VibrasticLab/pikoakustik/circuit/test_3rev1/end_stm32f401re.kicad_pcb

## KiCad design circuit/test_3rev1/end_stm32f401re.kicad_pcb (2020-10-08)

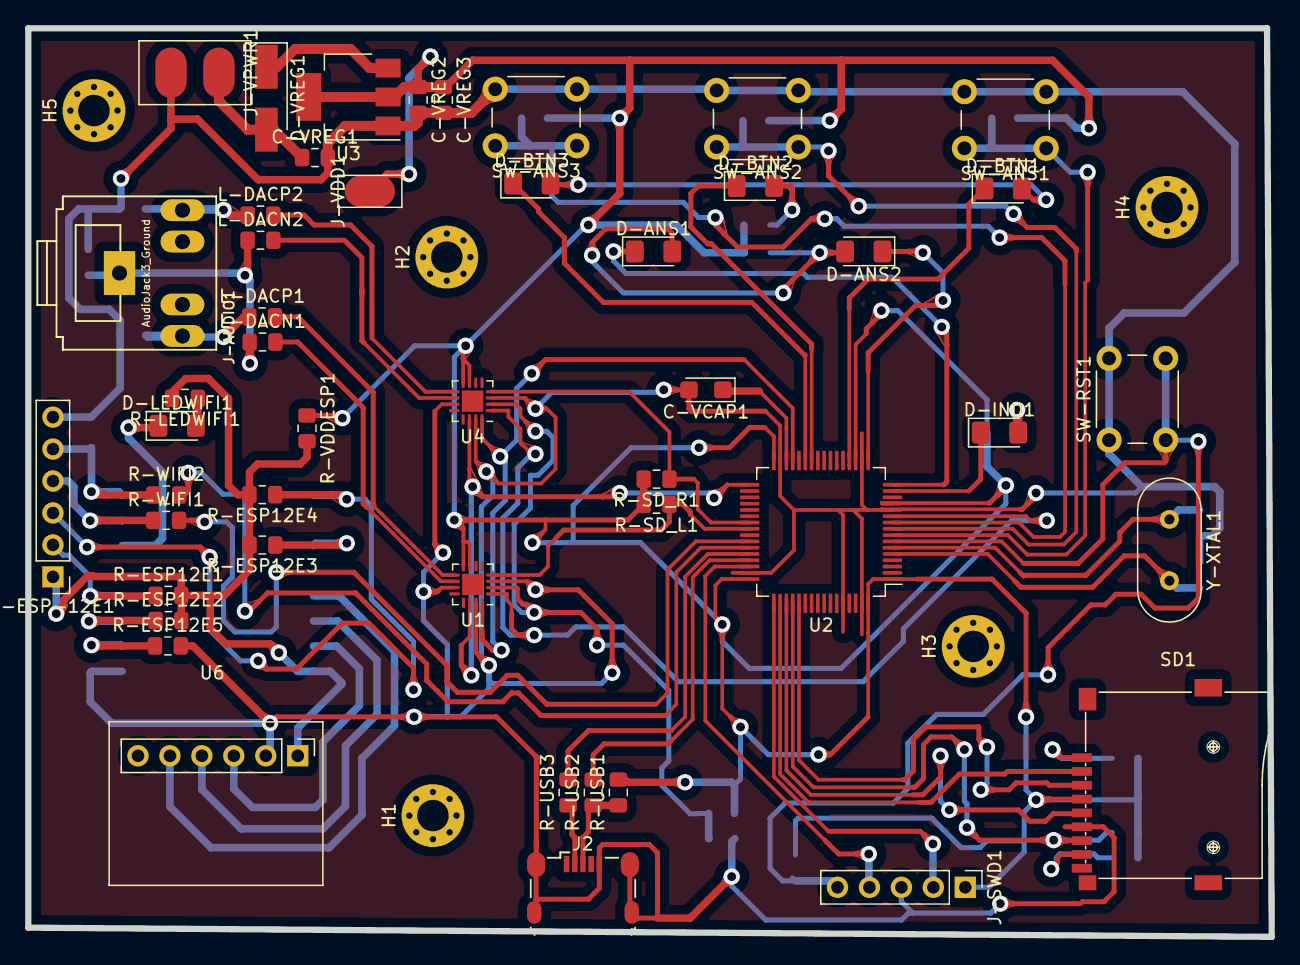
[picture p1: board end_stm32f401re.kicad_pcb from above]

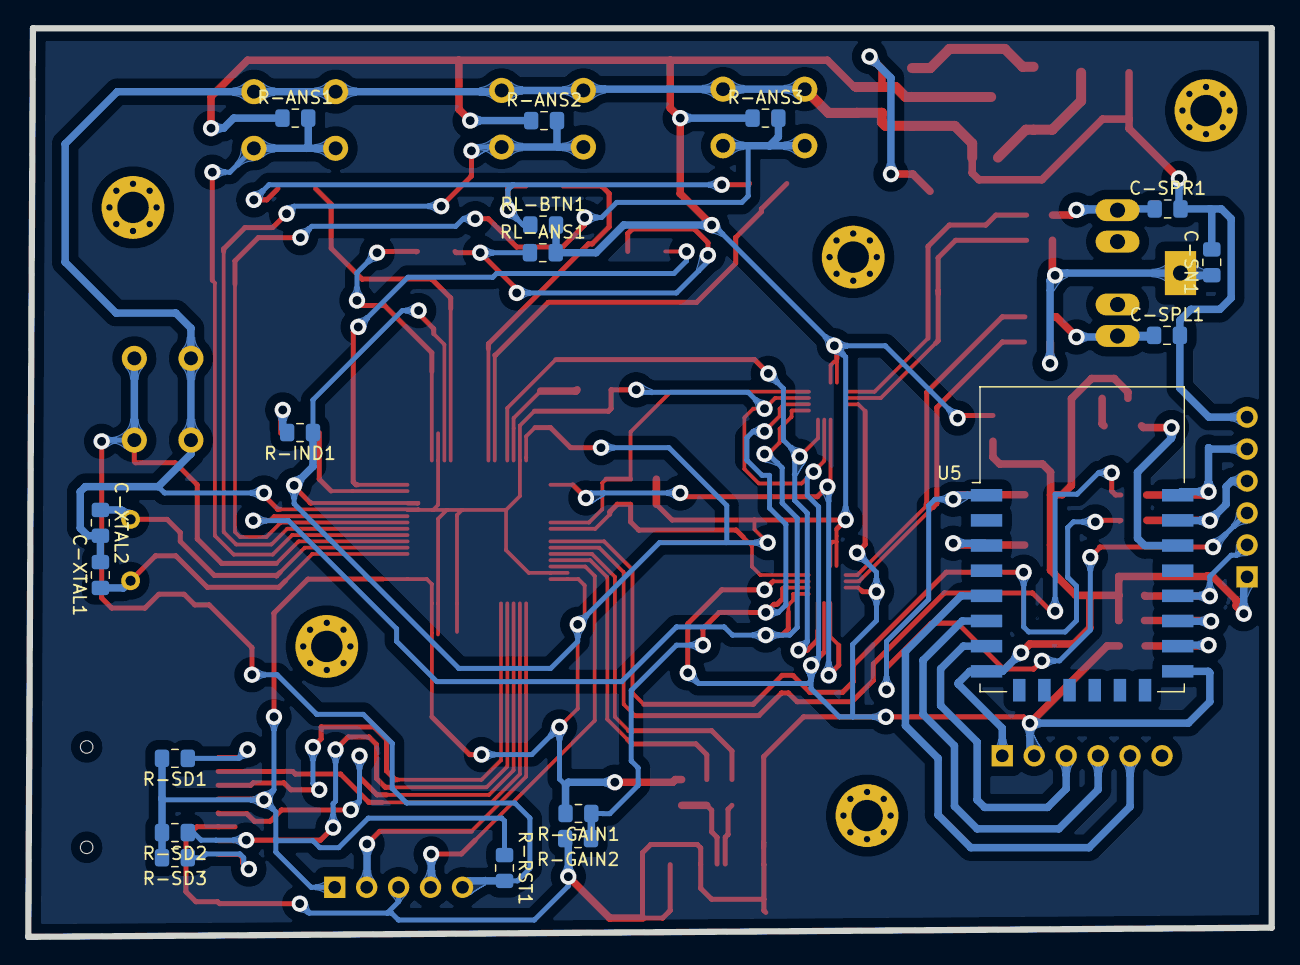
[picture p2: board end_stm32f401re.kicad_pcb from below]

Board: 2 copper layers, 98.9 x 72.2 mm, 70 parts (18 on the bottom side), 60 nets.

Parts:
C-SN1: 220pF; C_0805_2012Metric_Pad1.15x1.40mm_HandSolder
C-SPL1: 220pF; C_0805_2012Metric_Pad1.15x1.40mm_HandSolder
C-SPR1: 220pF; C_0805_2012Metric_Pad1.15x1.40mm_HandSolder
C-VCAP1: 4.7uF; CP_EIA-3216-18_Kemet-A
C-VREG1, C-VREG2, C-VREG3: C; C_0805_2012Metric_Pad1.15x1.40mm_HandSolder
C-XTAL1, C-XTAL2: C; C_0805_2012Metric_Pad1.15x1.40mm_HandSolder
D-ANS1, D-ANS2: LED; LED_1206_3216Metric_Pad1.42x1.75mm_HandSolder
D-BTN1, D-BTN2, D-BTN3: LED; LED_1206_3216Metric_Pad1.42x1.75mm_HandSolder
D-IND1: LED; LED_1206_3216Metric_Pad1.42x1.75mm_HandSolder
D-LEDWIFI1: LED; LED_1206_3216Metric_Pad1.42x1.75mm_HandSolder
D-VREG1: D; D_SMA_Handsoldering
H1, H2, H3, H4: MountingHole; MountingHole_2.5mm_Pad_Via
H5: CableHole; MountingHole_2.5mm_Pad_Via
J2: USB_B_Micro; MicroUSB
J-AUDIO1: AudioJack3_Ground; Tayda_3.5mm_stereo_TRS_jack_A-853
J-ESP-12E1: Conn_01x06_Male; PinHeader_1x06_P2.54mm_Vertical
J-SWD1: Conn_01x05_Male; PinHeader_1x05_P2.54mm_Vertical
J-VDD1: Conn_01x01_Male; vpin-x1
J-VPWR1: Conn_01x02_Male; vpin-x2
L-DACN1, L-DACN2: 100uH; L_0805_2012Metric_Pad1.15x1.40mm_HandSolder
L-DACP1, L-DACP2: 100uH; L_0805_2012Metric_Pad1.15x1.40mm_HandSolder
R-ANS1, R-ANS2, R-ANS3: 10K; R_0805_2012Metric_Pad1.15x1.40mm_HandSolder
R-ESP12E1, R-ESP12E2, R-ESP12E3, R-ESP12E4, R-ESP12E5: 10K; R_0805_2012Metric_Pad1.15x1.40mm_HandSolder
R-GAIN1, R-GAIN2: 100K; R_0805_2012Metric_Pad1.15x1.40mm_HandSolder
R-IND1: 330; R_0805_2012Metric_Pad1.15x1.40mm_HandSolder
R-LEDWIFI1: 330; R_0805_2012Metric_Pad1.15x1.40mm_HandSolder
R-RST1: 10K; R_0805_2012Metric_Pad1.15x1.40mm_HandSolder
R-SD1, R-SD2, R-SD3: 10K; R_0805_2012Metric_Pad1.15x1.40mm_HandSolder
R-SD_L1: 1M; R_0805_2012Metric_Pad1.15x1.40mm_HandSolder
R-SD_R1: 1M; R_0805_2012Metric_Pad1.15x1.40mm_HandSolder
R-USB1: 4K7; R_0805_2012Metric_Pad1.15x1.40mm_HandSolder
R-USB2, R-USB3: 68; R_0805_2012Metric_Pad1.15x1.40mm_HandSolder
R-VDDESP1: 0; R_0805_2012Metric_Pad1.15x1.40mm_HandSolder
R-WIFI1, R-WIFI2: 0; R_0805_2012Metric_Pad1.15x1.40mm_HandSolder
RL-ANS1: 330; R_0805_2012Metric_Pad1.15x1.40mm_HandSolder
RL-BTN1: 330; R_0805_2012Metric_Pad1.15x1.40mm_HandSolder
SD1: MICRO-SD-CARD-SOCKET-9P_ST-TF-003A_; MICRO-SD9+4P-SMD-16.1X14.5X1.85MM
SW-ANS1, SW-ANS2, SW-ANS3: SW_Push; SW_PUSH_6mm
SW-RST1: SW_Push; SW_PUSH_6mm
U1, U4: MAX98357; QFN-16-1EP_3x3mm_P0.5mm_EP1.7x1.7mm
U2: STM32F401RETx; LQFP-64_10x10mm_P0.5mm
U3: AMS1117-3.3; SOT-223-3_TabPin2
U5: ESP-12E
U6: SPH0645; sph0645
Y-XTAL1: 16MHz; Crystal_HC49-4H_Vertical

Connections:
/BTN_A: R-ANS1.2, SW-ANS1.1, U2.8
/BTN_B: R-ANS2.2, SW-ANS2.1, U2.9
/BTN_C: R-ANS3.2, SW-ANS3.1, U2.10
/DAC_BCLK: U1.16, U2.29, U4.16
/DAC_DIN: U1.1, U2.11, U4.1
/DAC_GAIN: R-GAIN1.1, R-GAIN2.1, U1.2, U4.2
/DAC_LRC: U1.14, U2.33, U4.14
/DAC_L_SD: R-SD_L1.1, U1.4, U2.40
/DAC_R_SD: R-SD_R1.1, U2.39, U4.4
/ESP_EN: R-ESP12E3.1, U5.3
/ESP_LEDWIFI: D-LEDWIFI1.1, U5.20
/ESP_P0: J-ESP-12E1.2, R-ESP12E1.1, U5.18
/ESP_P2: R-ESP12E2.1, U5.17
/ESP_P15: R-ESP12E5.1, U5.16
/ESP_RST: J-ESP-12E1.3, R-ESP12E4.1, U5.1
/ESP_RXD: J-ESP-12E1.4, R-WIFI1.1, U5.21
/ESP_TXD: J-ESP-12E1.5, R-WIFI2.1, U5.22
/LED_A: D-BTN1.1, U2.20
/LED_B: D-BTN2.1, U2.26
/LED_C: D-BTN3.1, U2.27
/LED_FALSE: D-ANS2.1, U2.17
/LED_IND: D-IND1.1, U2.15
/LED_TRUE: D-ANS1.1, U2.16
/MIC_BCLK: U5.7, U6.3
/MIC_DOUT: U5.6, U6.4
/MIC_LRCL: U5.5, U6.5
/MMC_MISO: R-SD2.1, SD1.7, U2.52
/MMC_MOSI: SD1.3, U2.53
/MMC_NSS: SD1.2, U2.50
/MMC_SCK: SD1.5, U2.51
/NRST: J-SWD1.5, R-RST1.2, SW-RST1.2, U2.7
/OUTN: C-SN1.1, J-AUDIO1.S, L-DACN1.1, L-DACN2.1
/OUTP_L: C-SPL1.1, J-AUDIO1.T, L-DACP1.1
/OUTP_R: C-SPR1.1, J-AUDIO1.R, L-DACP2.1
/SW_CLK: J-SWD1.2, U2.49
/SW_DIO: J-SWD1.4, U2.46
/USB_DM: R-USB3.2, U2.44
/USB_DP: R-USB2.2, U2.45
/VDD-ESP8266: J-ESP-12E1.1, R-ESP12E1.2, R-ESP12E2.2, R-ESP12E3.2, R-ESP12E4.2, R-LEDWIFI1.2, R-VDDESP1.2, U5.8, U6.1
/WIFI_RXD: R-WIFI2.2, U2.43
/WIFI_TXD: R-WIFI1.2, U2.42
GND: C-SN1.2, C-SPL1.2, C-SPR1.2, C-VCAP1.2, C-VREG1.2, C-VREG2.2, C-VREG3.2, C-XTAL1.2, C-XTAL2.2, J2.5, J2.6, J-ESP-12E1.6, J-SWD1.3, J-VPWR1.2, R-ESP12E5.2, R-GAIN2.2, SD1.6, SW-ANS1.2, SW-ANS2.2, SW-ANS3.2, SW-RST1.1, U1.3, U1.11, U1.15, U2.12, U2.18, U2.31, U2.47, U2.60, U2.63, U3.1, U4.3, U4.11, U4.15, U5.15, U6.2
unnamed: C-VCAP1.1, U2.30
unnamed: C-XTAL1.1, U2.5, Y-XTAL1.2
unnamed: C-XTAL2.1, U2.6, Y-XTAL1.1
unnamed: D-ANS1.2, D-ANS2.2, RL-ANS1.1
unnamed: D-BTN1.2, D-BTN2.2, D-BTN3.2, RL-BTN1.1
unnamed: D-IND1.2, R-IND1.2
unnamed: D-LEDWIFI1.2, R-LEDWIFI1.1
unnamed: D-VREG1.1, U3.3
unnamed: J2.2, R-USB3.1
unnamed: J2.3, R-USB1.1, R-USB2.1
unnamed: L-DACN1.2, U1.10
unnamed: L-DACN2.2, U4.10
unnamed: L-DACP1.2, U1.9
unnamed: L-DACP2.2, U4.9
unnamed: R-SD1.1, SD1.1
unnamed: R-SD3.1, SD1.8
VCC: C-VREG1.1, D-VREG1.2, J-VPWR1.1
VDD: C-VREG2.1, C-VREG3.1, J-SWD1.1, J-VDD1.1, R-ANS1.1, R-ANS2.1, R-ANS3.1, R-GAIN1.2, R-IND1.1, R-RST1.1, R-SD1.2, R-SD2.2, R-SD3.2, R-SD_L1.2, R-SD_R1.2, R-USB1.2, R-VDDESP1.1, RL-ANS1.2, RL-BTN1.2, SD1.4, U1.7, U1.8, U2.1, U2.13, U2.19, U2.32, U2.48, U2.64, U3.2, U4.7, U4.8
