VibrasticLab/pikoakustik/circuit/test_3nucleo/board_stm32f401re.kicad_pcb

## KiCad design circuit/test_3nucleo/board_stm32f401re.kicad_pcb (2020-06-01)

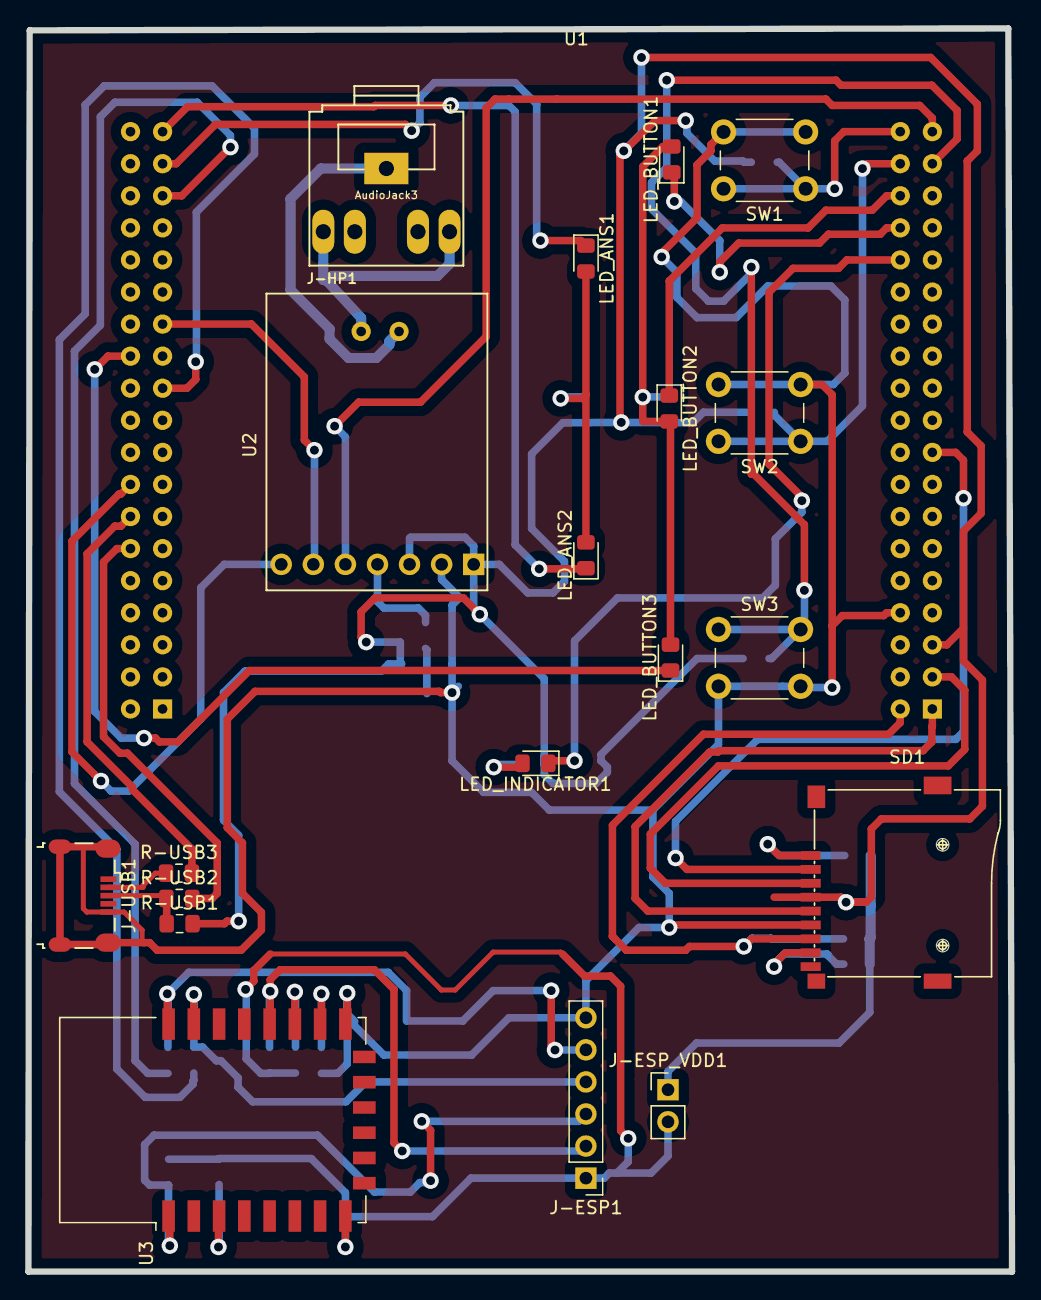
[picture p3: board board_stm32f401re.kicad_pcb from above]

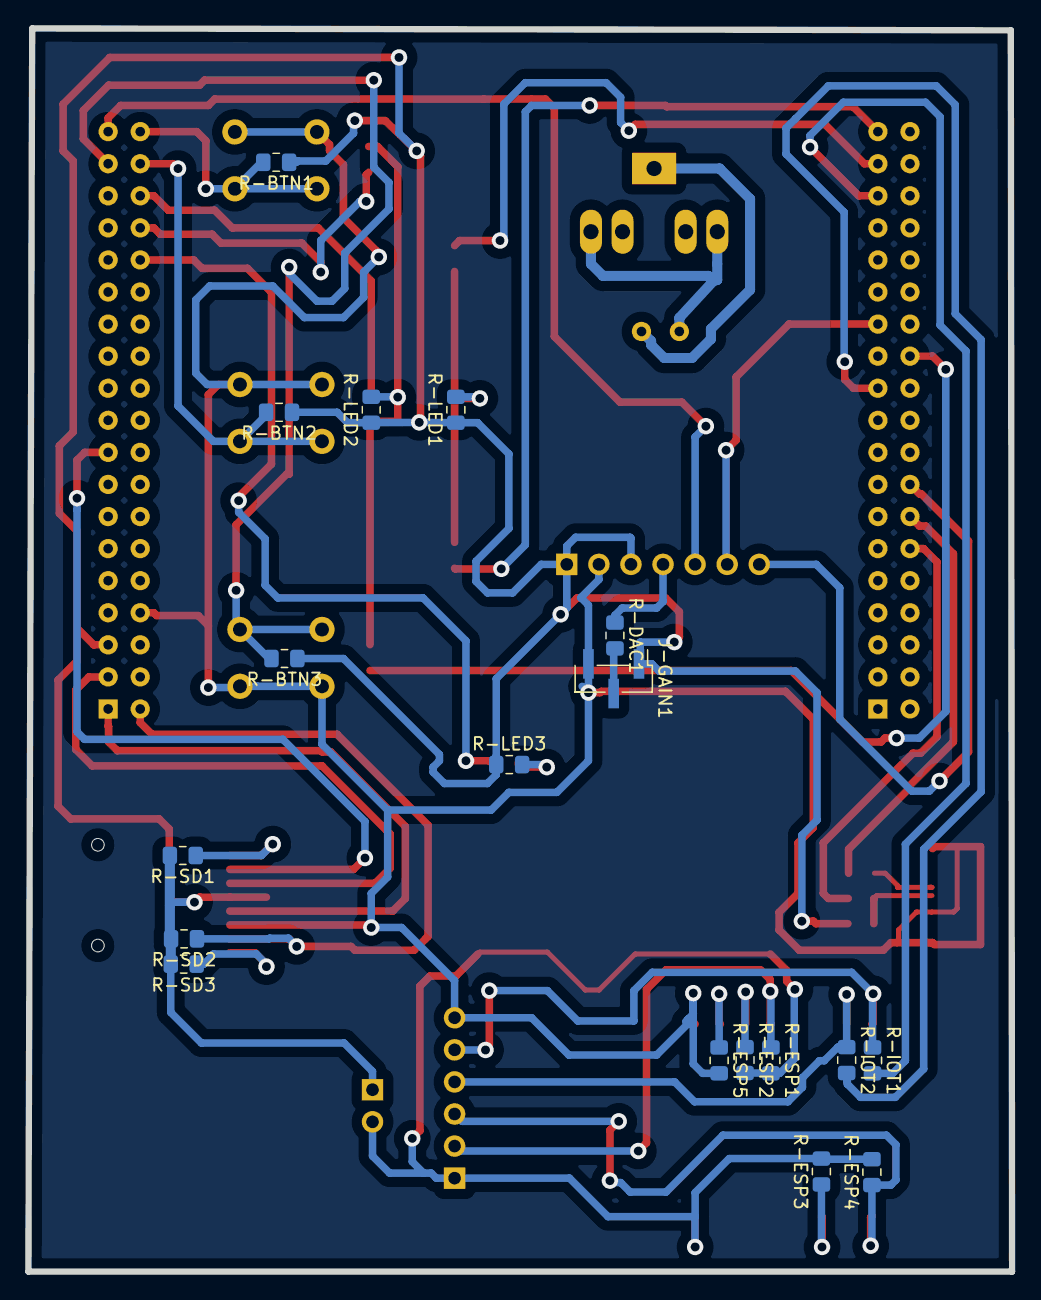
[picture p4: board board_stm32f401re.kicad_pcb from below]

Board: 2 copper layers, 77.9 x 98.5 mm, 38 parts (18 on the bottom side), 41 nets.

Parts:
J-ESP1: Conn_01x06_Male; PinHeader_1x06_P2.54mm_Vertical
J-ESP_VDD1: Conn_01x02_Male; PinHeader_1x02_P2.54mm_Vertical
J-GAIN1: Conn_01x03_Male; PinHeader_1x03_P2.00mm_Vertical_SMD_Pin1Left
J-HP1: AudioJack3; Tayda_3.5mm_stereo_TRS_jack_A-853
J-USB1: USB_B_Micro; MicroUSB
LED_ANS1, LED_ANS2: LED; LED_0805_2012Metric_Pad1.15x1.40mm_HandSolder
LED_BUTTON1, LED_BUTTON2, LED_BUTTON3: LED; LED_0805_2012Metric_Pad1.15x1.40mm_HandSolder
LED_INDICATOR1: LED; LED_0805_2012Metric_Pad1.15x1.40mm_HandSolder
R-BTN1, R-BTN2, R-BTN3: 4K7; R_0805_2012Metric_Pad1.15x1.40mm_HandSolder
R-DAC1: 100K; R_0805_2012Metric_Pad1.15x1.40mm_HandSolder
R-ESP1, R-ESP2, R-ESP3, R-ESP4, R-ESP5: 4K7; R_0805_2012Metric_Pad1.15x1.40mm_HandSolder
R-IOT1, R-IOT2: 0; R_0805_2012Metric_Pad1.15x1.40mm_HandSolder
R-LED1, R-LED2, R-LED3: 330; R_0805_2012Metric_Pad1.15x1.40mm_HandSolder
R-SD1, R-SD2, R-SD3: 4K7; R_0805_2012Metric_Pad1.15x1.40mm_HandSolder
R-USB1: 4K7; R_0805_2012Metric_Pad1.15x1.40mm_HandSolder
R-USB2, R-USB3: 68; R_0805_2012Metric_Pad1.15x1.40mm_HandSolder
SD1: MICRO-SD-CARD-SOCKET-9P_ST-TF-003A_; MICRO-SD9+4P-SMD-16.1X14.5X1.85MM
SW1, SW2, SW3: SW_Push; SW_PUSH_6mm
U1: NUCLEO-64; Nucleo-64
U2: MAX98357_DAC; dacmax98357
U3: ESP-12E

Connections:
/BTN_A: R-BTN1.2, SW1.1, U1.38
/BTN_B: R-BTN2.2, SW2.1, U1.36
/BTN_C: R-BTN3.2, SW3.1, U1.35
/DAC_BCLK: U1.63, U2.6
/DAC_DIN: U1.37, U2.5
/DAC_LRC: U1.54, U2.7
/ESP_EN: R-ESP3.1, U3.3
/ESP_P0: J-ESP1.2, R-ESP1.1, U3.18
/ESP_P2: R-ESP2.1, U3.17
/ESP_P15: R-ESP5.1, U3.16
/ESP_RST: J-ESP1.3, R-ESP4.1, U3.1
/ESP_RXD: J-ESP1.4, R-IOT2.1, U3.21
/ESP_TXD: J-ESP1.5, R-IOT1.1, U3.22
/ESP_VDD: J-ESP1.1, J-ESP_VDD1.2, R-ESP1.2, R-ESP2.2, R-ESP3.2, R-ESP4.2, U3.8
/LED_A: LED_BUTTON1.1, U1.32
/LED_B: LED_BUTTON2.1, U1.34
/LED_C: LED_BUTTON3.1, U1.62
/LED_FALSE: LED_ANS2.1, U1.75
/LED_IND: LED_INDICATOR1.1, U1.30
/LED_TRUE: LED_ANS1.1, U1.73
/MMC_MISO: R-SD2.1, SD1.7, U1.2
/MMC_MOSI: SD1.3, U1.3
/MMC_NSS: SD1.2, U1.17
/MMC_SCK: SD1.5, U1.1
/RXD: R-IOT1.2, U1.71
/TXD: R-IOT2.2, U1.59
/USB_DM: R-USB3.2, U1.52
/USB_DP: R-USB2.2, U1.50
GND: J-ESP1.6, J-GAIN1.3, J-USB1.5, J-USB1.6, R-ESP5.2, SD1.6, SW1.2, SW2.2, SW3.2, U1.8, U2.2, U3.15
unnamed: J-GAIN1.2, R-DAC1.2
unnamed: J-HP1.R, J-HP1.T, U2.9
unnamed: J-HP1.S, U2.8
unnamed: J-USB1.2, R-USB3.1
unnamed: J-USB1.3, R-USB1.1, R-USB2.1
unnamed: LED_ANS1.2, LED_ANS2.2, R-LED1.2
unnamed: LED_BUTTON1.2, LED_BUTTON2.2, LED_BUTTON3.2, R-LED2.2
unnamed: LED_INDICATOR1.2, R-LED3.2
unnamed: R-DAC1.1, U2.4
unnamed: R-SD1.1, SD1.1
unnamed: R-SD3.1, SD1.8
VDD: J-ESP_VDD1.1, J-GAIN1.1, R-BTN1.1, R-BTN2.1, R-BTN3.1, R-LED1.1, R-LED2.1, R-LED3.1, R-SD1.2, R-SD2.2, R-SD3.2, R-USB1.2, SD1.4, U1.5, U2.1, U2.3
